gabriel-lando/WegInverterController/README.md

# WegInverterController

Controlador para o Inversor de Frequencia WEG CFW100 v4.21

## Configuração

| Parâmetro | Valor | Comentário |
| --- | ----- | --- |
| P002 | 35.0  | Define a referência de velocidade do motor |
| P100 | 360.0 | Tempo da rampa de subida no primeiro sentido (~210 s em 35Hz) |
| P101 | 103.0 | Tempo da rampa de descida no primeiro sentido (~60 s em 35Hz) |
| P102 | 106.0 | Tempo da rampa de subida no segundo sentido (~60 s em 35Hz) |
| P103 | 85.0  | Tempo da rampa de descida no segundo sentido (~50 s em 35Hz) |
| P105 | 2 | Define a seleção de rampa para as portas digitais |
| P107 | 5.0 | Tempo da rampa de descida de emergencia (parada rápida) |
| P133 | 3.0 | Frequência mínima do motor |
| P134 | 60.0  | Frequência máxima do motor (necessário para P142) |
| P136 | 5.0 | Boost de torque manual |
| P142 | 100.0 | Tensão maxima de saída |
| P145 | 60.0  | Frequência máxima de saída (fixo em 60Hz pra não queimar o motor (??)) |
| P202 | 0 | Modo do inversor V/f escalar |
| P220 | 4 | Define a seleção de fonte para as portas digitais |
| P223 | 4 | Define a seleção de giro para as portas digitais |
| P224 | 1 | Define a seleção de gira/para para as portas digitais |
| P263 | 1 | Define a porta D1 como função Gira/Para |
| P264 | 8 | Define a porta D2 como função de mudança do Sentido de Giro |
| P265 | 14 | Define a porta D3 como função de mudança de Rampa |
| P266 | 3 | Define a porta D4 como função de Parada Rápida (Emergência) |

## Diagrama

<p align="center">
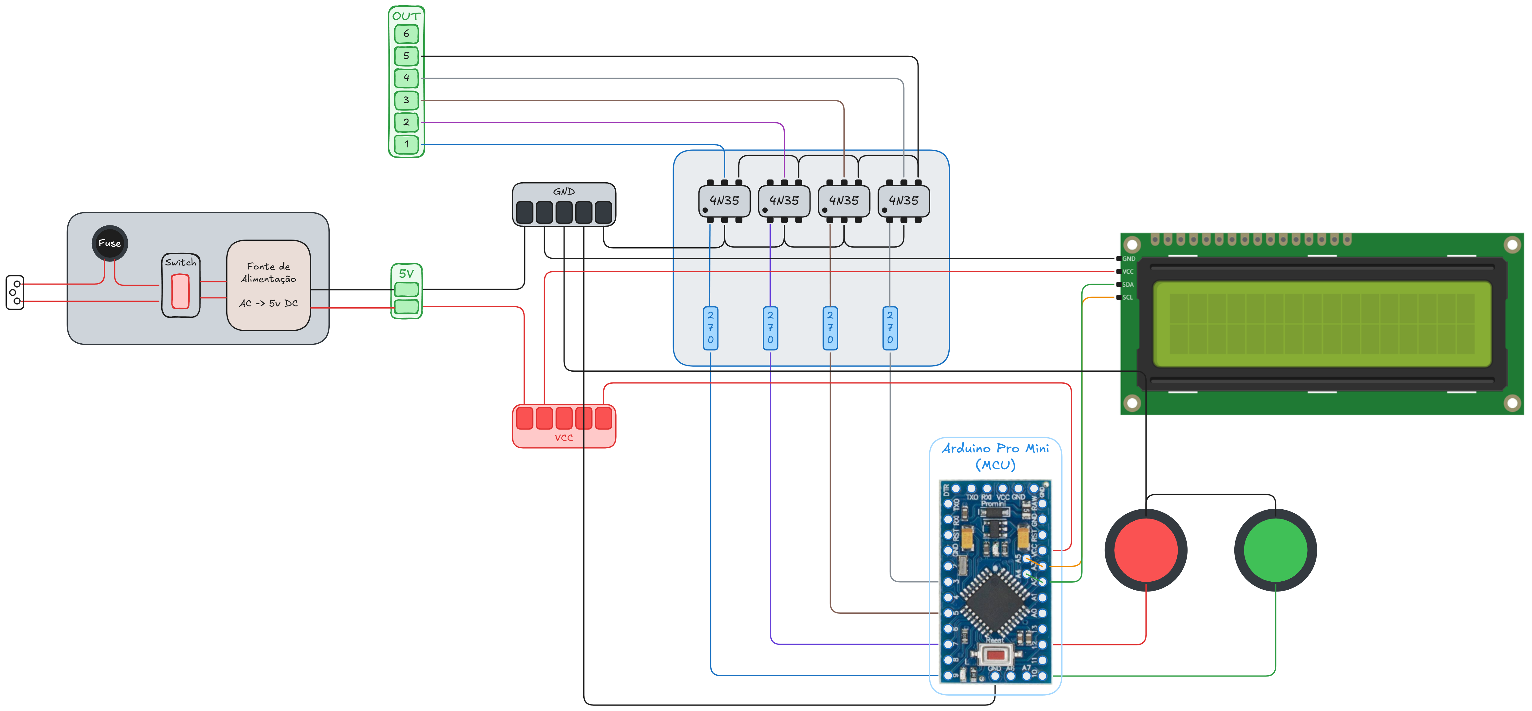
[picture p1: Docs/WegControllerDiagram.png]
Diagrama
  
</p>

- Excalidraw: [WegControllerDiagram.excalidraw](Docs/WegControllerDiagram.excalidraw)

## Fotos

### Fonte de Alimentação

<p align="center">
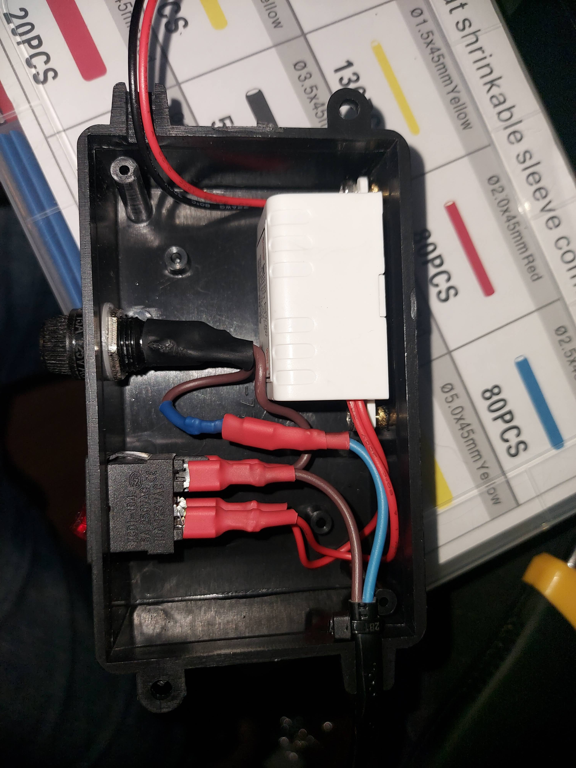
[picture p2: Docs/Photos/PowerSupply.jpg]
Fonte de Alimentação
  
</p>

### PCB

<table>
  <tr>
    <td align="center">
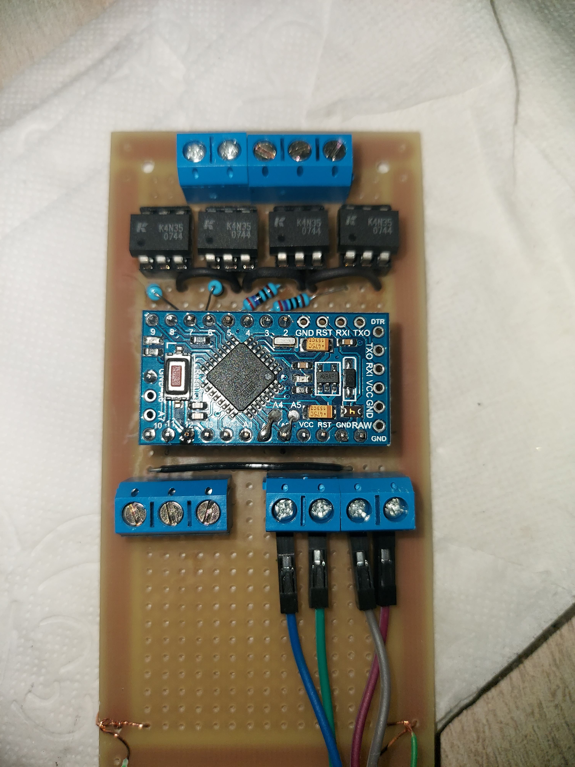
[picture p3: Docs/Photos/PCB_Front.jpg]
PCB Frente
      
    </td>
    <td align="center">
PCB Verso
      
    </td>
  </tr>
</table>

### Montagem

<table>
  <tr>
    <td align="center">
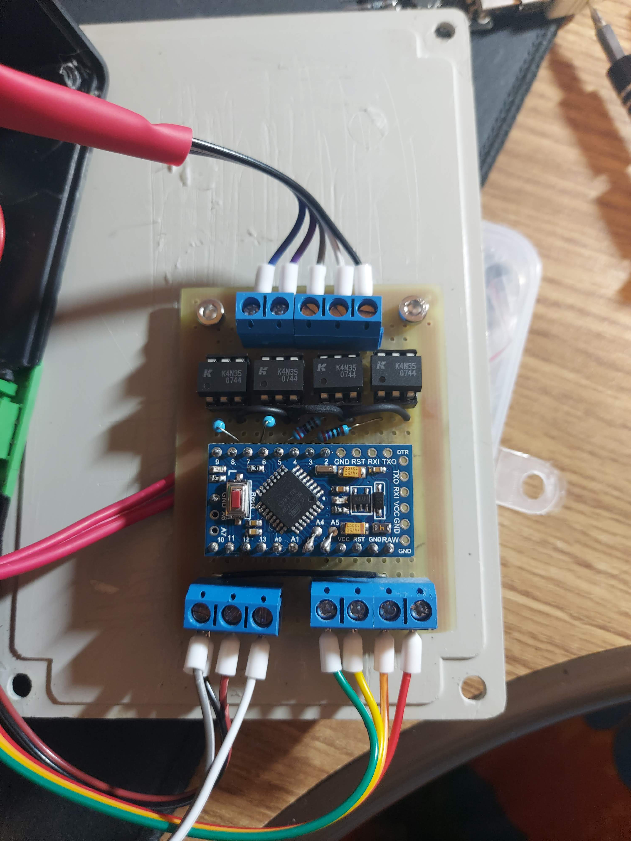
[picture p5: Docs/Photos/Mounted_PCB.jpg]
Montagem da PCB
      
    </td>
    <td align="center">
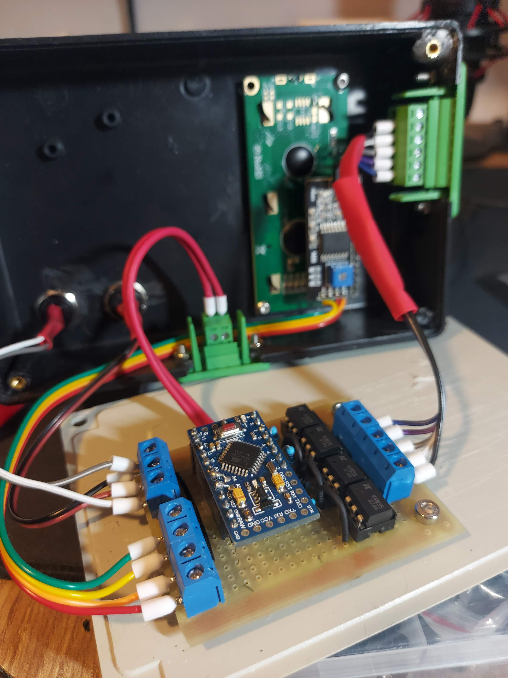
[picture p6: Docs/Photos/Mounted_All.jpg]
Montagem completa
      
    </td>
  </tr>
  <tr>
    <td colspan="2" align="center">
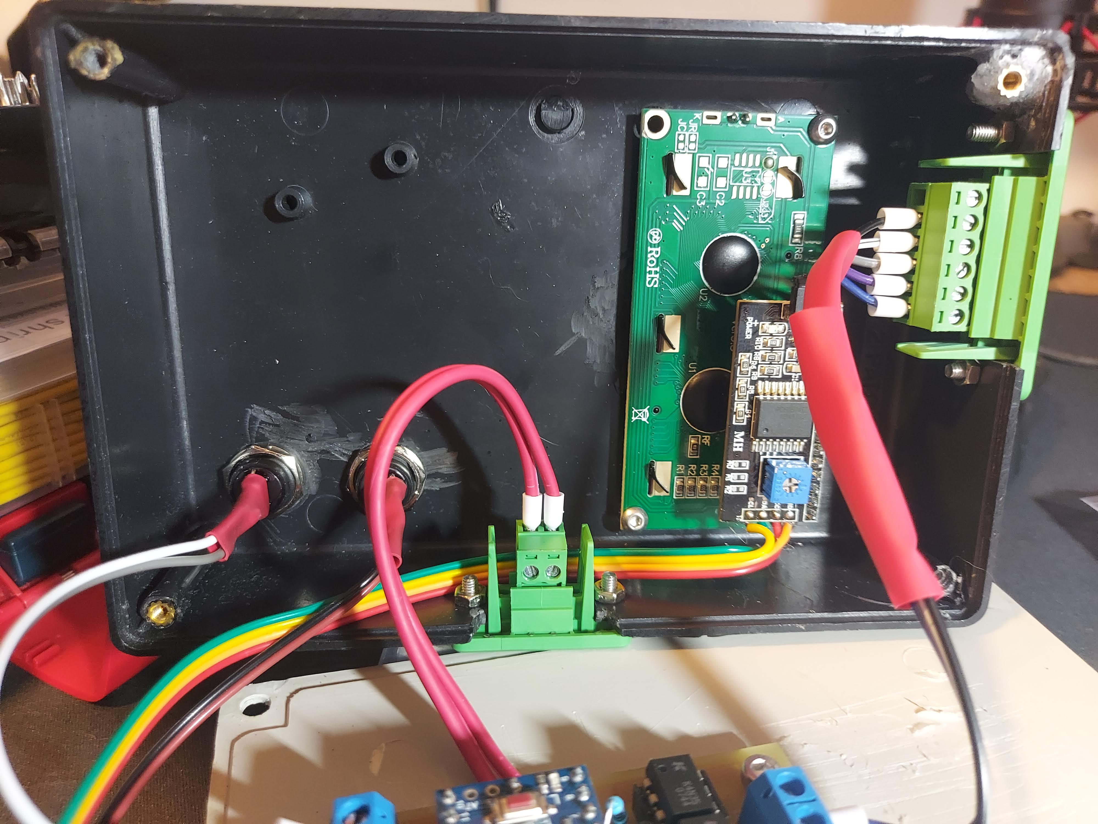
[picture p7: Docs/Photos/Mounted_Front.jpg]
Montagem do Painel Frontal
      
    </td>
  </tr>
</table>
