gabriel-lando/WegInverterController/WegInverterController/Settings.h

#ifndef _SETTINGS_H_
#define _SETTINGS_H_

const unsigned char START_PIN = 9;
const unsigned char DIRECTION_PIN = 7;
const unsigned char RAMP_PIN = 5;
const unsigned char ENABLE_PIN = 3;

const unsigned char START_BTN = 10;
const unsigned char STOP_BTN = 12;

const unsigned long RAMP_1_UP_TIME = 210;
const unsigned long DIRECTION_1_TIME = 120;
const unsigned long RAMP_1_DOWN_TIME = 60;

const unsigned long RAMP_2_UP_TIME = 60;
const unsigned long DIRECTION_2_TIME = 120;
const unsigned long RAMP_2_DOWN_TIME = 50;

const unsigned long EMERGENCY_STOP_TIME = 5;

#endif
