gabriel-lando/WegInverterController/(commit log)

2025-02-04 Create WEG CFW100 - Manual de Programacao.pdf
2025-02-04 Create WEG CFW100 - Guia de Instalacao Rapida.pdf
