gabriel-lando/WegInverterController/Docs/Photos/PCB_Back.jpg

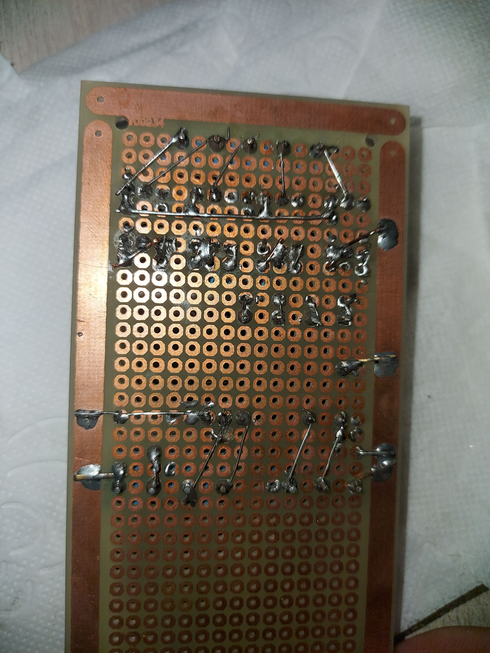
[picture p4: Docs/Photos/PCB_Back.jpg]
Docs/Photos/PCB_Back.jpg
